PaulZC/Cabin_Pressure_Logger/Logger_2.jpg

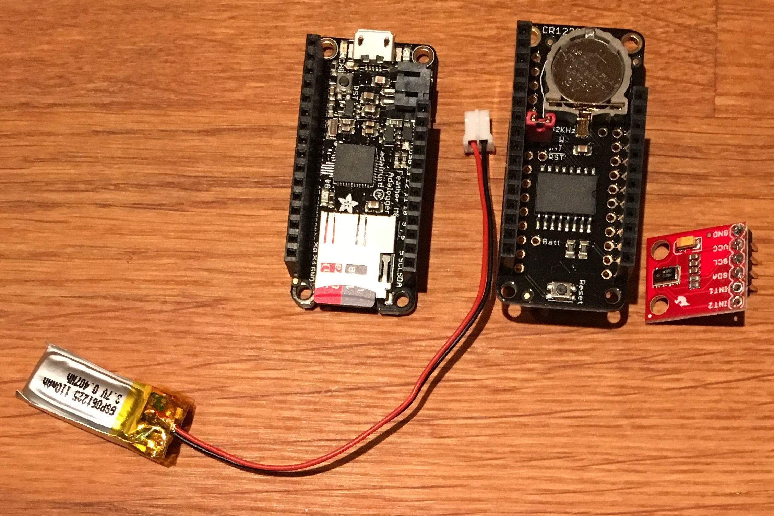
Logger_2.jpg
