PaulZC/Cabin_Pressure_Logger/Logger_1.jpg

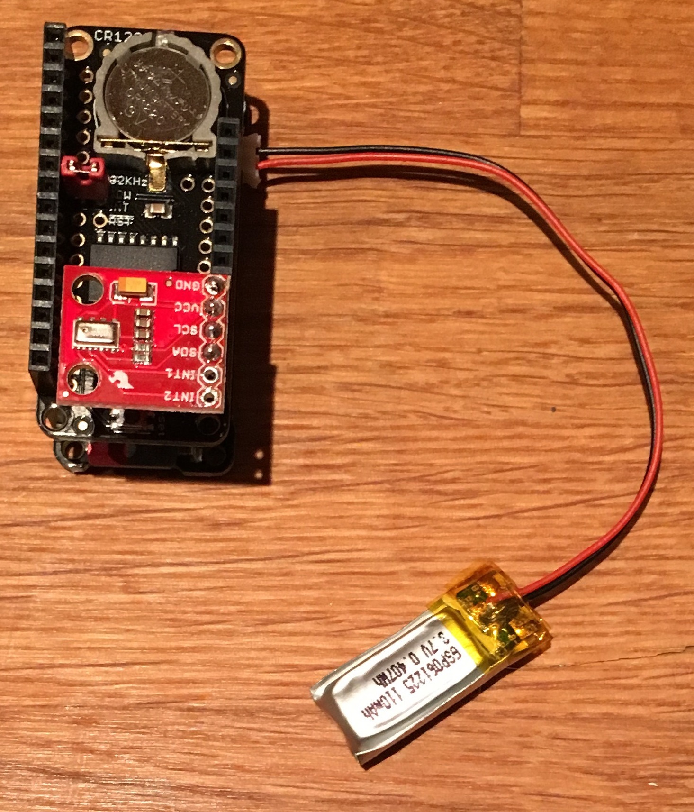
Logger_1.jpg
