PaulZC/Cabin_Pressure_Logger/README

Cabin_Pressure_Logger
=====================

Instructions for a DIY cabin (atmospheric) pressure logger based around the Adafruit Feather Adalogger M0.

Complete (ish!) instructions are included in "Cabin_Pressure_Logging_with_the_Adafruit_Feather_Adalogger_M0.pdf".

Enjoy!
